HexabitzPlatform/H0BR4x-Hardware/README.md

# H0BR41-Hardware
Hexabitz IMU &amp; Digital Compass Module Hardware Design
