HexabitzPlatform/H0BR4x-Hardware/Released/BOM/H0BR4.xlsx

 |  | www.hexabitz.com info@hexabitz.com |  |  | Bill Of Materials
Customer | Hexabitz | Revision | 1
Project | Hexabitz Modules | Date | 2022-10-30
Board | IMU and eCompass (H0BR4) | Notes
Designator | Description | Manufacturer Part Number | Manufacturer | Octopart Url | Quantity
J3 | Headers & Wire Housings Unshrouded 1 POS T/H | 5-146280-1 | TE Connectivity | https://octopart.com/5-146280-1-te+connectivity+%2F+amp-40259676?r=sp | 1
JP1 | Conn Unshrouded Header HDR 3 POS 2.54mm Solder ST Top Entry Thru-Hole Carton | 5-146281-3 | TE Connectivity | https://octopart.com/5-146281-3-te+connectivity+%2F+amp-39745942?r=sp | 1
R3 | RES SMD 0.0OHM JUMPER 1/10W 0603 | RC0603JR-070RL | YAGEO [VR] | https://octopart.com/rc0603jr-070rl-yageo-1241539?r=sp | 1
R1 | Thick Film Resistors - SMD 0603 270 Ohm 5% Tol | ERJ-3GEYJ271V | Panasonic | https://octopart.com/erj-3geyj271v-panasonic-55560546?r=sp | 1
R4, R5 | RES 2.20K OHM 1/10W 1% 0603 SMD | RC0603FR-072K2L | Yageo | https://octopart.com/rc0603fr-072k2l-yageo-1214512?r=sp (https://octopart.com/crcw060310k0jneb-vishay-46603269) | 2
R2 | RES 10 K OHM 5% 0603 | 060300J0103T5E | Vishay | https://octopart.com/crcw060310k0jneb-vishay-46603269 | 1
C1, C6, C7, C8, C10, C11, C12, C13 | CAP CER 0.1 UF 10% X7R 0603 | C0603C104K8RACTU | KEMET | https://octopart.com/c0603c104k8ractu-kemet-145075?r=sp&s=9bS9ASSwSEqMCE9KBEQZ0g | 8
C2 | CAP CER 1 UF 16V X7R 0805 | CC0805KKX7R7BB105 | YAGEO [VA] | https://octopart.com/cc0805kkx7r7bb105-yageo-8376555?r=sp | 1
C4, C3 | CAP TANT 4.7 UF 10V 20% 0805 | 10TPU4R7MSI | Panasonic | https://octopart.com/10tpu4r7msi-panasonic-29487748?r=sp | 2
C14 | CAP 100v 0,22uf KEMET Multilayer Ceramic Capacitors MLCC-SMD/ | C0805C224K1RACTU | KEMET | https://octopart.com/c0805c224k1ractu-kemet-12818106?r=sp | 1
FB1 | Ind chip Bead Multi-Layer 30 ohms 25% 100MHZ Ferrite 1,5A 0603Punched paper T/R | MMZ1608Y300BTA00 | TDK | https://octopart.com/mmz1608y300bta00-tdk-7906990?r=sp | 1
D1 | Red 0603 130° Clear 54 mcd 2 V Surface Mount ChipLED | VLMS1300-GS08 | Vishay | https://octopart.com/vlms1300-gs08-vishay-21709201?r=sp&s=0nXJNjGsSbWwqfqWlZv0EA | 1
D2 | TVS DIODE 3,3V 10,9V SOD323 | CDSOD323-T03SC | BOURNS INC | https://octopart.com/cdsod323-t03sc-bourns-10487153?r=sp | 1
U1 | MCU 32-Bit ARM Cortex-M0+ RISC 512kByte Flash 1.7V to 3.6V 48-Pin UFQFPN Tray | STM32G0B1CEU6N | STMicroelectronics | https://octopart.com/stm32g0b1ceu6n-stmicroelectronics-116364672?r=sp | 1
U2 | STMicroelectronics iNEMO inertial module: 3D accelerometer and 3D gyroscope | LSM6DS3TR-C | STMicroelectronics | https://octopart.com/lsm6ds3tr-c-stmicroelectronics-90586301?r=sp | 1
U3 | Ultra-compact high-performance e-compass 3D accelerometer and 3D magnetometer module | LSM303AGRTR | STMicroelectronics | https://octopart.com/lsm303agrtr-stmicroelectronics-59386630?r=sp | 1
X1 | 8,0000MHZ 33pF SMD MURATA Resonators | CSTNE8M00G550000R0 | Murata | https://octopart.com/cstne8m00g550000r0-murata-91406934?r=sp | 1
