HexabitzPlatform/H0BR4x-Hardware/Documentation/H0BR4 Schematics.pdf

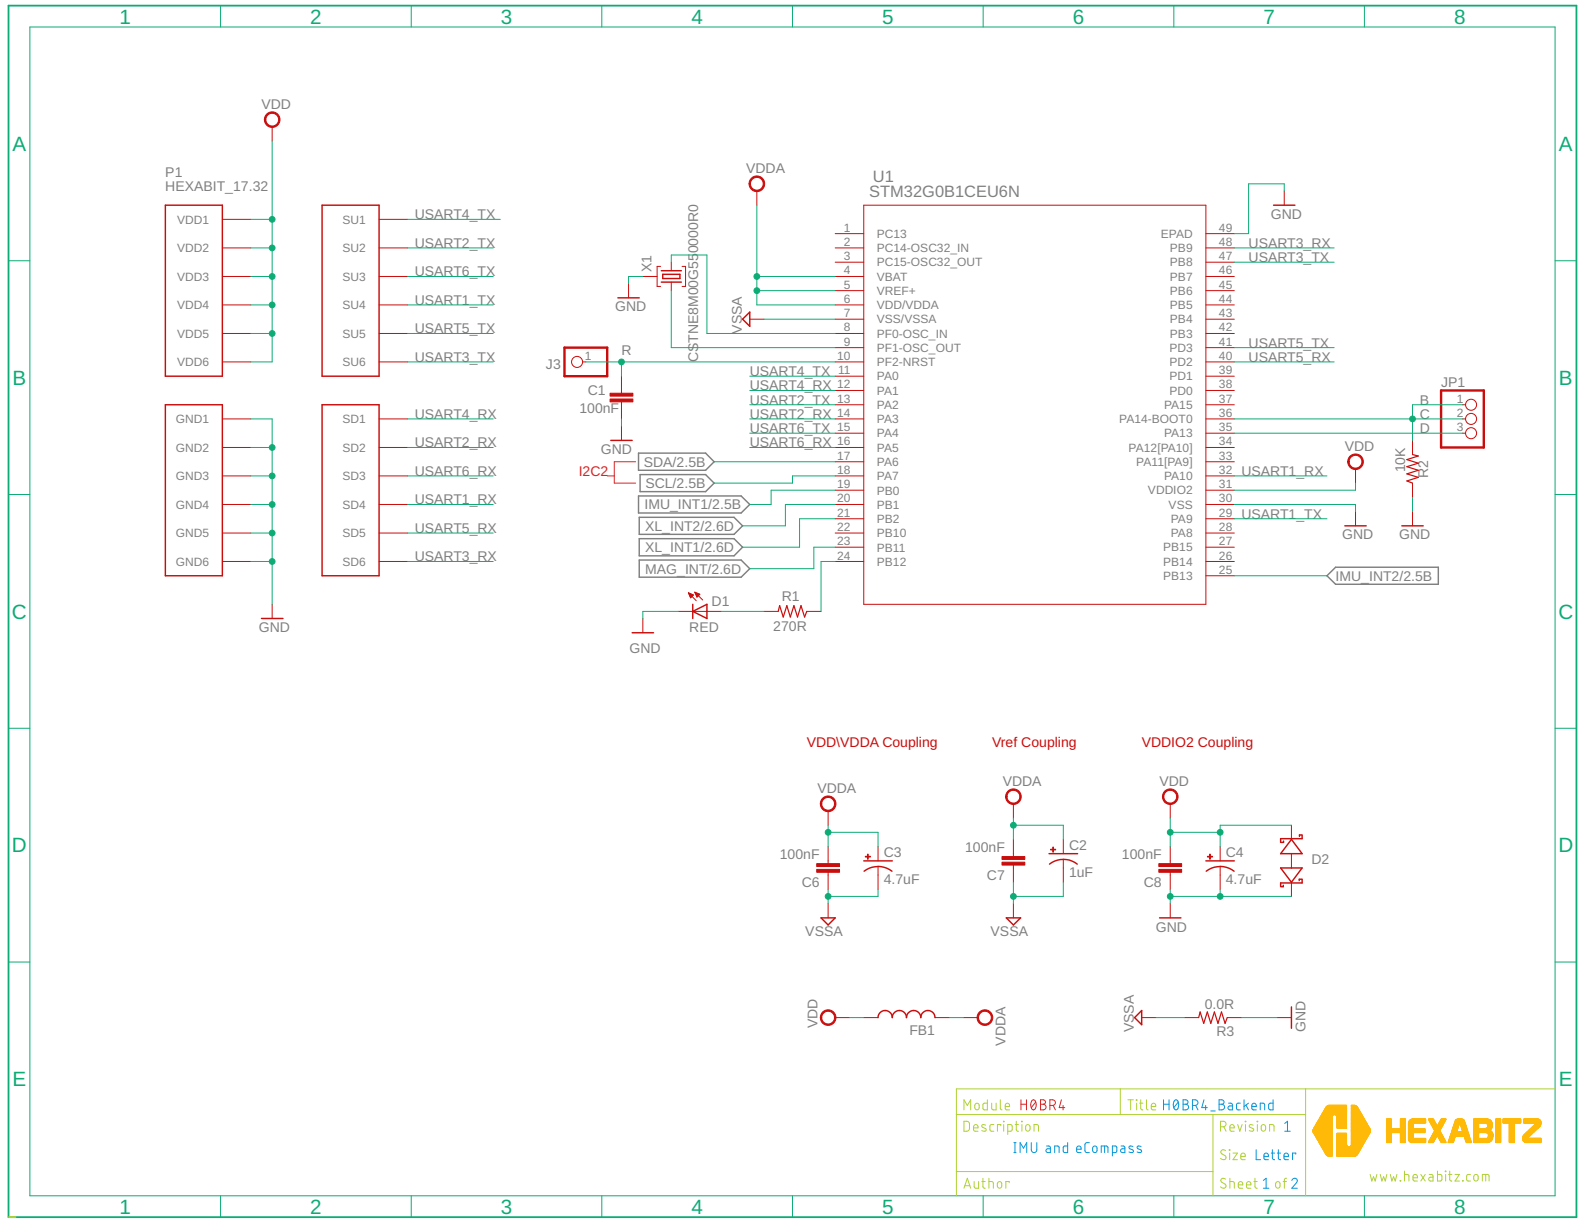
[picture p1: page 1]

5 | 45 PB7
6 | 44 PB6

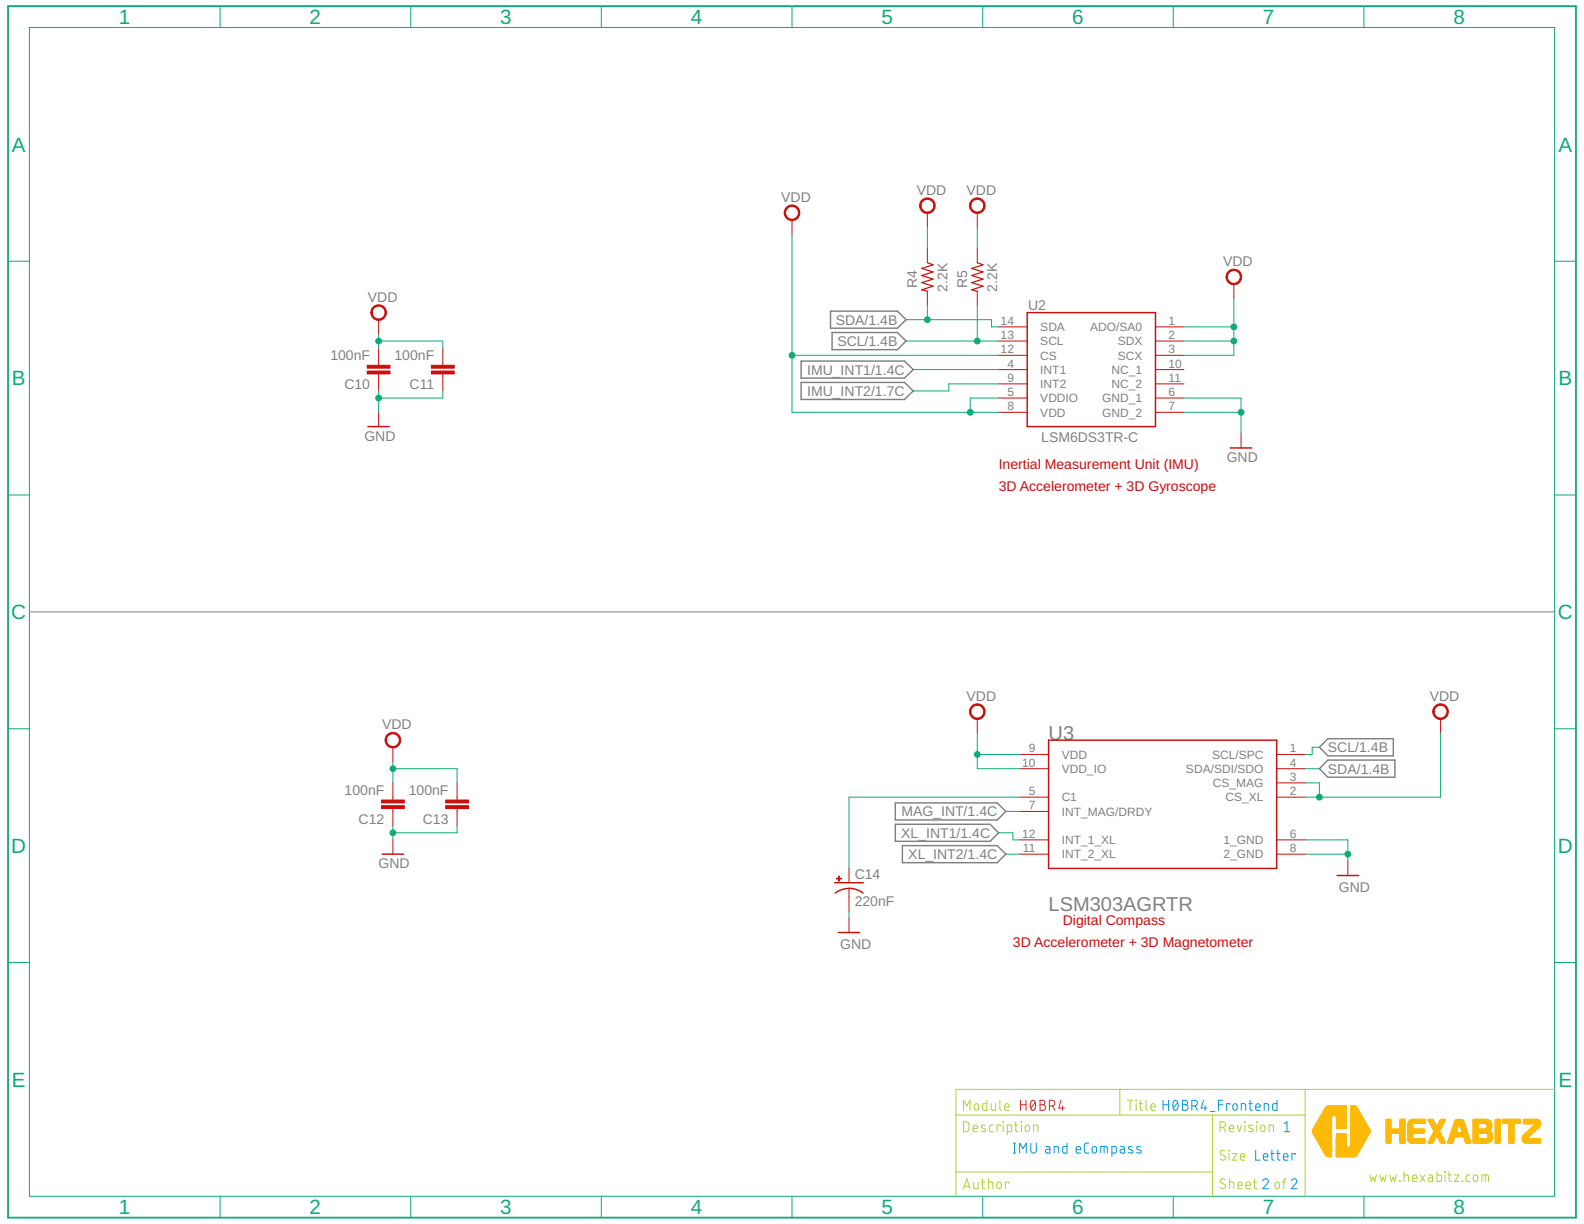
[picture p2: page 2]

Inertial Measurement Unit (IMU)
3D Accelerometer + 3D Gyroscope

LSM303AGRTR
Digital Compass 3D Accelerometer + 3D Magnetometer
