HexabitzPlatform/H0BR4x-Hardware/Design/H0BR4.brd

## EAGLE design Design/H0BR4.brd (2024-05-16)

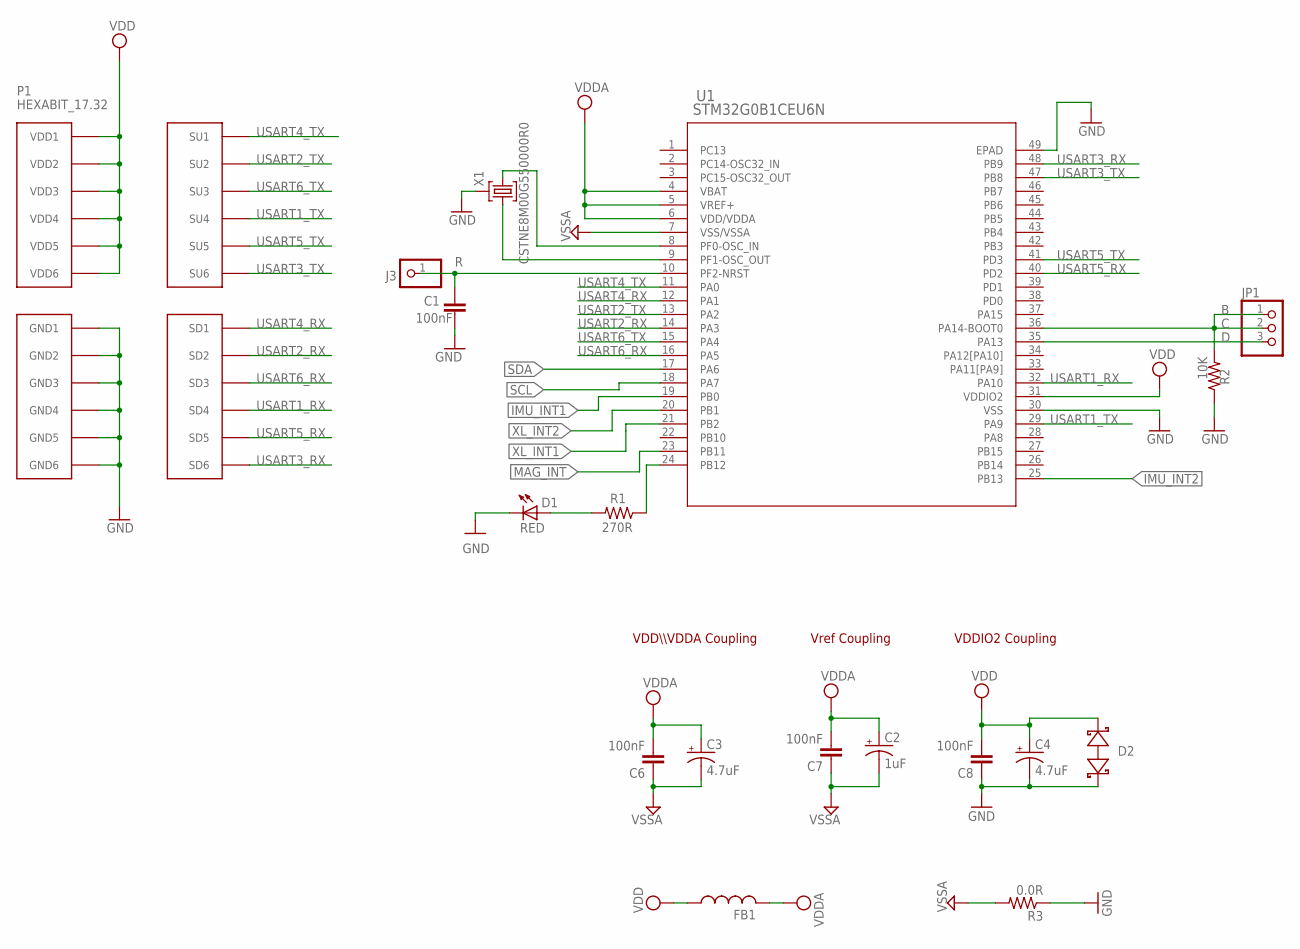
[picture p3: schematic H0BR4.sch, sheet 1]

Parts:
C1, C6, C7, C8: 100nF; C-0603; TOLERANCE 10%; VOLTAGE_RATING 16.0 V; MPN '0603YC104K4T2A
C2: 1uF; C-0805-POL; TOLERANCE 10%; VOLTAGE_RATING 16.0 V; MPN 'CC0805KKX7R7BB105
C3, C4: 4.7uF; C-0805-POL; TOLERANCE 20%; VOLTAGE_RATING 10.0 V; MPN 10TPU4R7MSI
D1: RED; VLMS1300-GS08
D2: BOURNS_CDSOD323-T03SCBOURNS_CDSOD323-T03SC_0_0; BOURNS_CDSOD323-T03SC_0
FB1: FB-TDK_MMZ1608Y300B; MPN MMZ1608Y300BTA00
J3: PINHD-1X1; 1X01
JP1: PINHD-1X3; 1X03
P1: HEXABIT_17.32
R1: 270R; R-0603; MPN 'ERJ-3GEYJ271V
R2: 10K; R-0603; MPN '060300J0103T5E
R3: 0.0R; R-0603; MPN RC0603JR-070RL
TRIMBLE-LOGO1: HEXA-LOGO
U1: STM32G0B1CEU6N; HEXABITZ_ICS_QFN_B1CEU6_STM-L
X1: CSTNE8M00G550000R0; XTALL_CSTCE8M00G52; MPN CSTNE8M00G550000R0

Connections:
C: JP1.1, JP1.2, R2.2, U1.36 (PA14-BOOT0)
D: JP1.3, U1.35 (PA13)
GND: C1.1, C4.2 (-), C8.1, D1.C, D2.1 (A), P1.PAD_PD7 (GND1), P1.PAD_PD8 (GND2), P1.PAD_PD9 (GND3), P1.PAD_PD10 (GND4), P1.PAD_PD11 (GND5), P1.PAD_PD12 (GND6), R2.1, R3.1, U1.30 (VSS), U1.49 (EPAD), X1.P$2 (2); also elsewhere on the board
GND1: C2.2 (-), C3.2 (-), C6.1, C7.1, R3.2, U1.7 (VSS/VSSA)
IMU_INT1: U1.19 (PB0); also elsewhere on the board
IMU_INT2: U1.25 (PB13); also elsewhere on the board
MAG_INT: U1.23 (PB11); also elsewhere on the board
unnamed: R1.1, U1.24 (PB12)
unnamed: U1.9 (PF1-OSC_OUT), X1.P$3 (3)
unnamed: D1.A, R1.2
unnamed: U1.8 (PF0-OSC_IN), X1.P$1 (1)
R: C1.2, J3.1, U1.10 (PF2-NRST)
SCL: U1.18 (PA7); also elsewhere on the board
SDA: U1.17 (PA6); also elsewhere on the board
USART1_RX: P1.PAD_PD4 (SD4), U1.32 (PA10)
USART1_TX: P1.PAD_PU4 (SU4), U1.29 (PA9)
USART2_RX: P1.PAD_PD2 (SD2), U1.14 (PA3)
USART2_TX: P1.PAD_PU2 (SU2), U1.13 (PA2)
USART3_RX: P1.PAD_PD6 (SD6), U1.48 (PB9)
USART3_TX: P1.PAD_PU6 (SU6), U1.47 (PB8)
USART4_RX: P1.PAD_PD1 (SD1), U1.12 (PA1)
USART4_TX: P1.PAD_PU1 (SU1), U1.11 (PA0)
USART5_RX: P1.PAD_PD5 (SD5), U1.40 (PD2)
USART5_TX: P1.PAD_PU5 (SU5), U1.41 (PD3)
USART6_RX: P1.PAD_PD3 (SD3), U1.16 (PA5)
USART6_TX: P1.PAD_PU3 (SU3), U1.15 (PA4)
VCC: C2.1 (+), C3.1 (+), C6.2, C7.2, FB1.2, U1.4 (VBAT), U1.5 (VREF+), U1.6 (VDD/VDDA)
VDD: C4.1 (+), C8.2, D2.2 (C), FB1.1, P1.PAD_PU7 (VDD1), P1.PAD_PU8 (VDD2), P1.PAD_PU9 (VDD3), P1.PAD_PU10 (VDD4), P1.PAD_PU11 (VDD5), P1.PAD_PU12 (VDD6), U1.31 (VDDIO2); also elsewhere on the board
XL_INT1: U1.21 (PB2); also elsewhere on the board
XL_INT2: U1.20 (PB1); also elsewhere on the board

Notes on the sheet:
VDDIO2 Coupling
VDD\\\VDDA Coupling
Vref Coupling

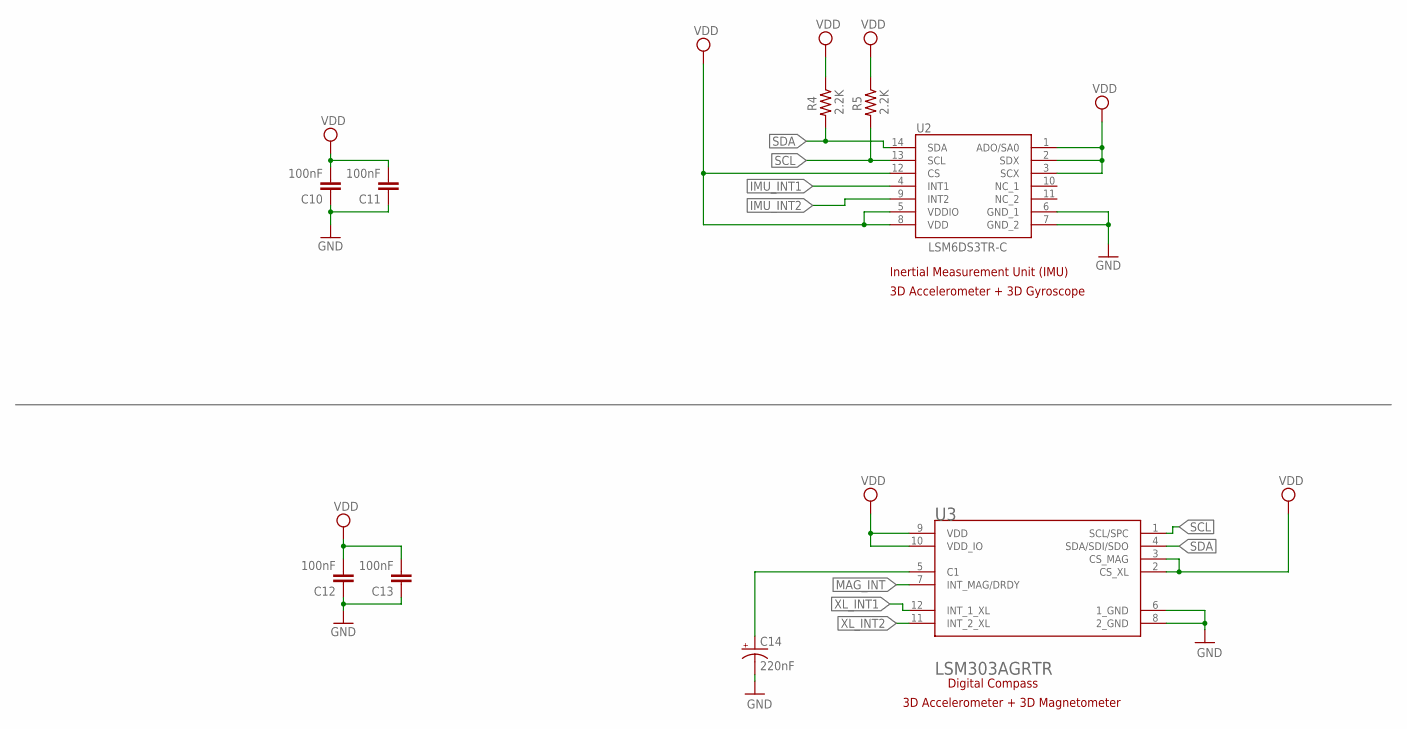
[picture p4: schematic H0BR4.sch, sheet 2]

Parts:
C10, C11, C12, C13: 100nF; C-0603; TOLERANCE 10%; VOLTAGE_RATING 16.0 V; MPN '0603YC104K4T2A
C14: 220nF; C-0805-POL; TOLERANCE 20%; VOLTAGE_RATING 10.0 V; MPN C0805C224K1RACTU
R4, R5: 2.2K; R-0603; TOLERANCE 5%; MPN RC0603FR-072K2L
U2: LSM6DS3TR-C; LGA-14(2.5X3X0.86)
U3: STMICROELECTRONICS_LSM303AGRTRSTMICROELECTRONICS_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; STMICROELECTRONICS_LSM303AGRTR_0

Connections:
GND: C10.1, C11.1, C12.1, C13.1, C14.2 (-), U2.6 (GND_1), U2.7 (GND_2), U3.6 (1_GND), U3.8 (2_GND); also elsewhere on the board
IMU_INT1: U2.4 (INT1); also elsewhere on the board
IMU_INT2: U2.9 (INT2); also elsewhere on the board
MAG_INT: U3.7 (INT_MAG/DRDY); also elsewhere on the board
unnamed: C14.1 (+), U3.5 (C1)
SCL: R5.2, U2.13 (SCL), U3.1 (SCL/SPC); also elsewhere on the board
SDA: R4.2, U2.14 (SDA), U3.4 (SDA/SDI/SDO); also elsewhere on the board
VDD: C10.2, C11.2, C12.2, C13.2, R4.1, R5.1, U2.1 (ADO/SA0), U2.2 (SDX), U2.3 (SCX), U2.5 (VDDIO), U2.8 (VDD), U2.12 (CS), U3.2 (CS_XL), U3.3 (CS_MAG), U3.9 (VDD), U3.10 (VDD_IO); also elsewhere on the board
XL_INT1: U3.12 (INT_1_XL); also elsewhere on the board
XL_INT2: U3.11 (INT_2_XL); also elsewhere on the board

Notes on the sheet:
Inertial Measurement Unit (IMU)
3D Accelerometer + 3D Gyroscope
Digital Compass
3D Accelerometer + 3D Magnetometer

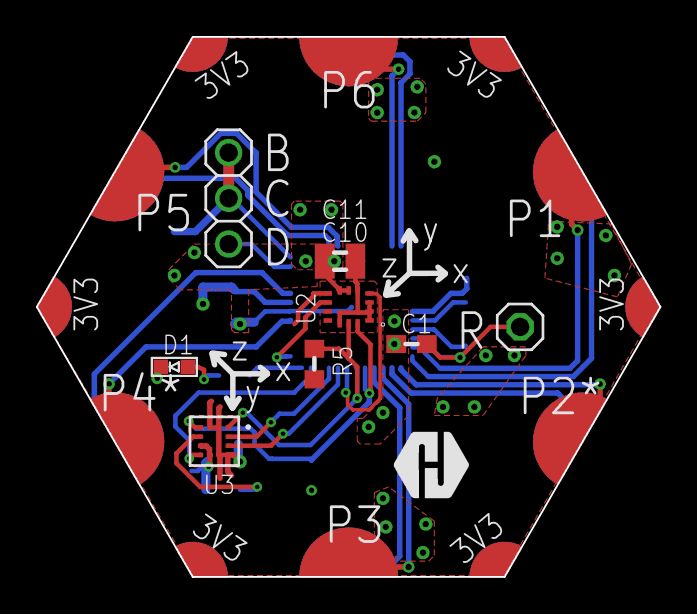
[picture p5: board H0BR4.brd from above]

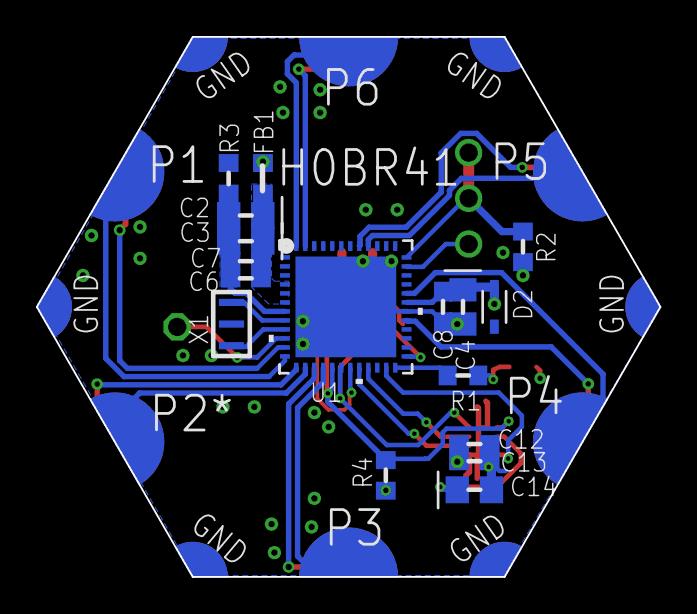
[picture p6: board H0BR4.brd from below]

Board: 2 copper layers, 34.6 x 30.0 mm, 28 parts (17 on the bottom side), 31 nets.
