HexabitzPlatform/H0BR4x-Hardware/(threads)

Thread 1 (2019-09-01):

Fix and review BOM

HexabitzGit, 2019-09-01:

Closed 2021-04-27.
