HexabitzPlatform/H0BR4x-Hardware/(commit log)

2019-05-23 First release rev 0
    [H0BR40.brd, H0BR40.sch, H0BR40.xlsx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]
2020-03-11 in this commit: - renamed all res and caps to match circuitmaker original design - fixed BOM files (note: in circuit maker and website C15 should be C14) - regenerated documentation and all output fi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
    [H0BR40.brd, H0BR40.sch, H0BR40.xlsx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]
2022-08-23 Changing the MC to STM32G0B1CEU6N
    [H0BR40.brd, H0BR40.sch, H0BR40.xlsx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]
2022-08-23 Changing the MC to STM32G0B1CEU6
    [H0BR41.brd, H0BR41.sch, H0BR41_Bom..xlsx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]
2022-09-13 -Changing the layout to be like of master design in terms of the position of sensors ICs . -Changing the Schematic as well
    [H0BR41.brd, H0BR41.sch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]
2022-09-13 -Correcting some fault connections
    [H0BR41.brd, H0BR41.sch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]
2022-10-30 -Correcting some issues related to part names
    [H0BR41.brd, H0BR41.sch, H0BR41.xlsx, H0BR41_Bom..xlsx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]
2024-02-15 -Improving the layout
    [H0BR4.brd, H0BR4.sch, H0BR41.brd, H0BR41.xlsx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]
2024-02-24 -Fix documentaion issue
    [H0BR41.xlsx]
2024-04-17 update the logo add TVS
    [H0BR4.brd, H0BR4.sch, H0BR4.xlsx, H0BR41.xlsx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]
2024-04-17 Fix silkscreen issue
    [H0BR4.brd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]
2024-05-16 -Standrize the folders arranging -Remove C9 from the BOM
    [H0BR4.brd, H0BR4.sch, H0BR4.xlsx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]
